AlexSunNik/Autonomous-Toy-Car/README.md

# Autonomous-toy-car
Build with flex sensors and ultrasonic sensors. Users can control the movements of car by showing different gestures.
